SerwindTurtle/Based-on-the-Gowin-Tang-Mega-60K-FPGA-Multi-timbre-synthesis-electronic-musical-instrument-engine/技术文档/README.md

# 技术文档

## 当前主文档

| 文件 | 说明 |
|---|---|
| `基于高云Tang_Mega_60K_FPGA的多音色合成电子乐器引擎_技术文档_v1.0.docx` | 按赛题模板编写的完整技术文档，20 页、3 张表、8 张生成框图 + 8 处待拍/待截图 |
| `技术文档模板_副本.docx` | 赛题模板副本，供对照排版 |
| `图片清单.md` | 需要补拍的实物照片、界面截图和框图清单 |
| `figures/` | 已生成的 8 张框图/流程图 PNG 源文件 |

## 说明

- 已生成：设计流程、系统总体、硬件连接、ADS1115 接线、音频链路、RTL 层次、单声部数据流、效果链。
- 仍需实拍/截图：键盘与传感器装配、网页控制台、HDMI 界面、整机正面/45°、电路实物、延迟测试（可选）。
- 正文中的蓝色底纹段落是**待拍摄/待截图的位置和拍摄建议**，替换为图片后删除该段提示。
- 图片不包含学校名称、校徽、实验室标识等赛题禁止信息。
- 技术数据以 `2026-10-27 21:44` 码流为准：LUT 44771（74.7%）、DSP 108.5/118（92%）、BSRAM 34、setup +0.040ns、hold +0.247ns、0 违例。
- v0.1/v0.2 历史文档已从当前仓库清理，避免与 v1.0 混淆；旧版本只在本地备份中保留。
