SerwindTurtle/Based-on-the-Gowin-Tang-Mega-60K-FPGA-Multi-timbre-synthesis-electronic-musical-instrument-engine/技术文档/CHANGELOG.md

# 版本记录

## v1.0 — 2026-10-29

**内容**

- 项目名称统一为 **“基于高云Tang Mega 60K FPGA的多音色合成电子乐器引擎”**，封面、摘要和文档属性同步更新。
- 按赛题五部分模板重写技术文档：作品概述、系统组成及功能说明、完成情况及性能参数、总结、参考文献。
- 当前文档 20 页、3 张表、8 张生成框图、8 处待拍/截图。
- 覆盖当前实现：8 键压力感应、8 个独立按键声部、32 个并行振荡器层（8 键×4 层）、10 种硬件音色 + 网页自定义、
  发送式效果链、PWM、HDMI 波形/4 段频谱、UART 网页控制台。
- 明确标注未实现/不演示项：蓝牙/APP、在线下载、录音回放、LED 演奏指引、李萨如、9–32 通道独立处理。

**数据**

- 资源与时序取 `2026-10-27 21:44` 码流：LUT 44771/59904（74.7%）、DSP 108.5/118（92%）、BSRAM 34/118、
  setup +0.040ns / hold +0.247ns、0 违例。
- 32 个振荡器层按“8 个主声部 + 24 个共用包络的齐奏层”表述，不写成 32 键复音。
- HDMI 频谱按“4 段一阶滤波器组，显示成 8 条”表述，不写成 FFT。

**图表**

- 3 张表：主要性能指标、主要 RTL/软件模块、功能与性能测试结果。
- 8 张生成框图：设计流程、系统总体、硬件连接、ADS1115 接线、音频链路、RTL 层次、单声部数据流、效果链。
- 8 处待拍/待截图：键盘/传感器装配、网页控制台、HDMI 界面、整机正面/45°、电路实物、延迟测试（可选）。
- 图片源文件在 `figures/`，拍摄/截图建议见 `图片清单.md`。

**交付**

- `基于高云Tang_Mega_60K_FPGA的多音色合成电子乐器引擎_技术文档_v1.0.docx`
- 历史 v0.1/v0.2 已清理，不随当前仓库提交。
